jkramarz/TheTick/hardware/Tick.kicad_pcb

## KiCad design hardware/Tick.kicad_pcb (2025-04-05)

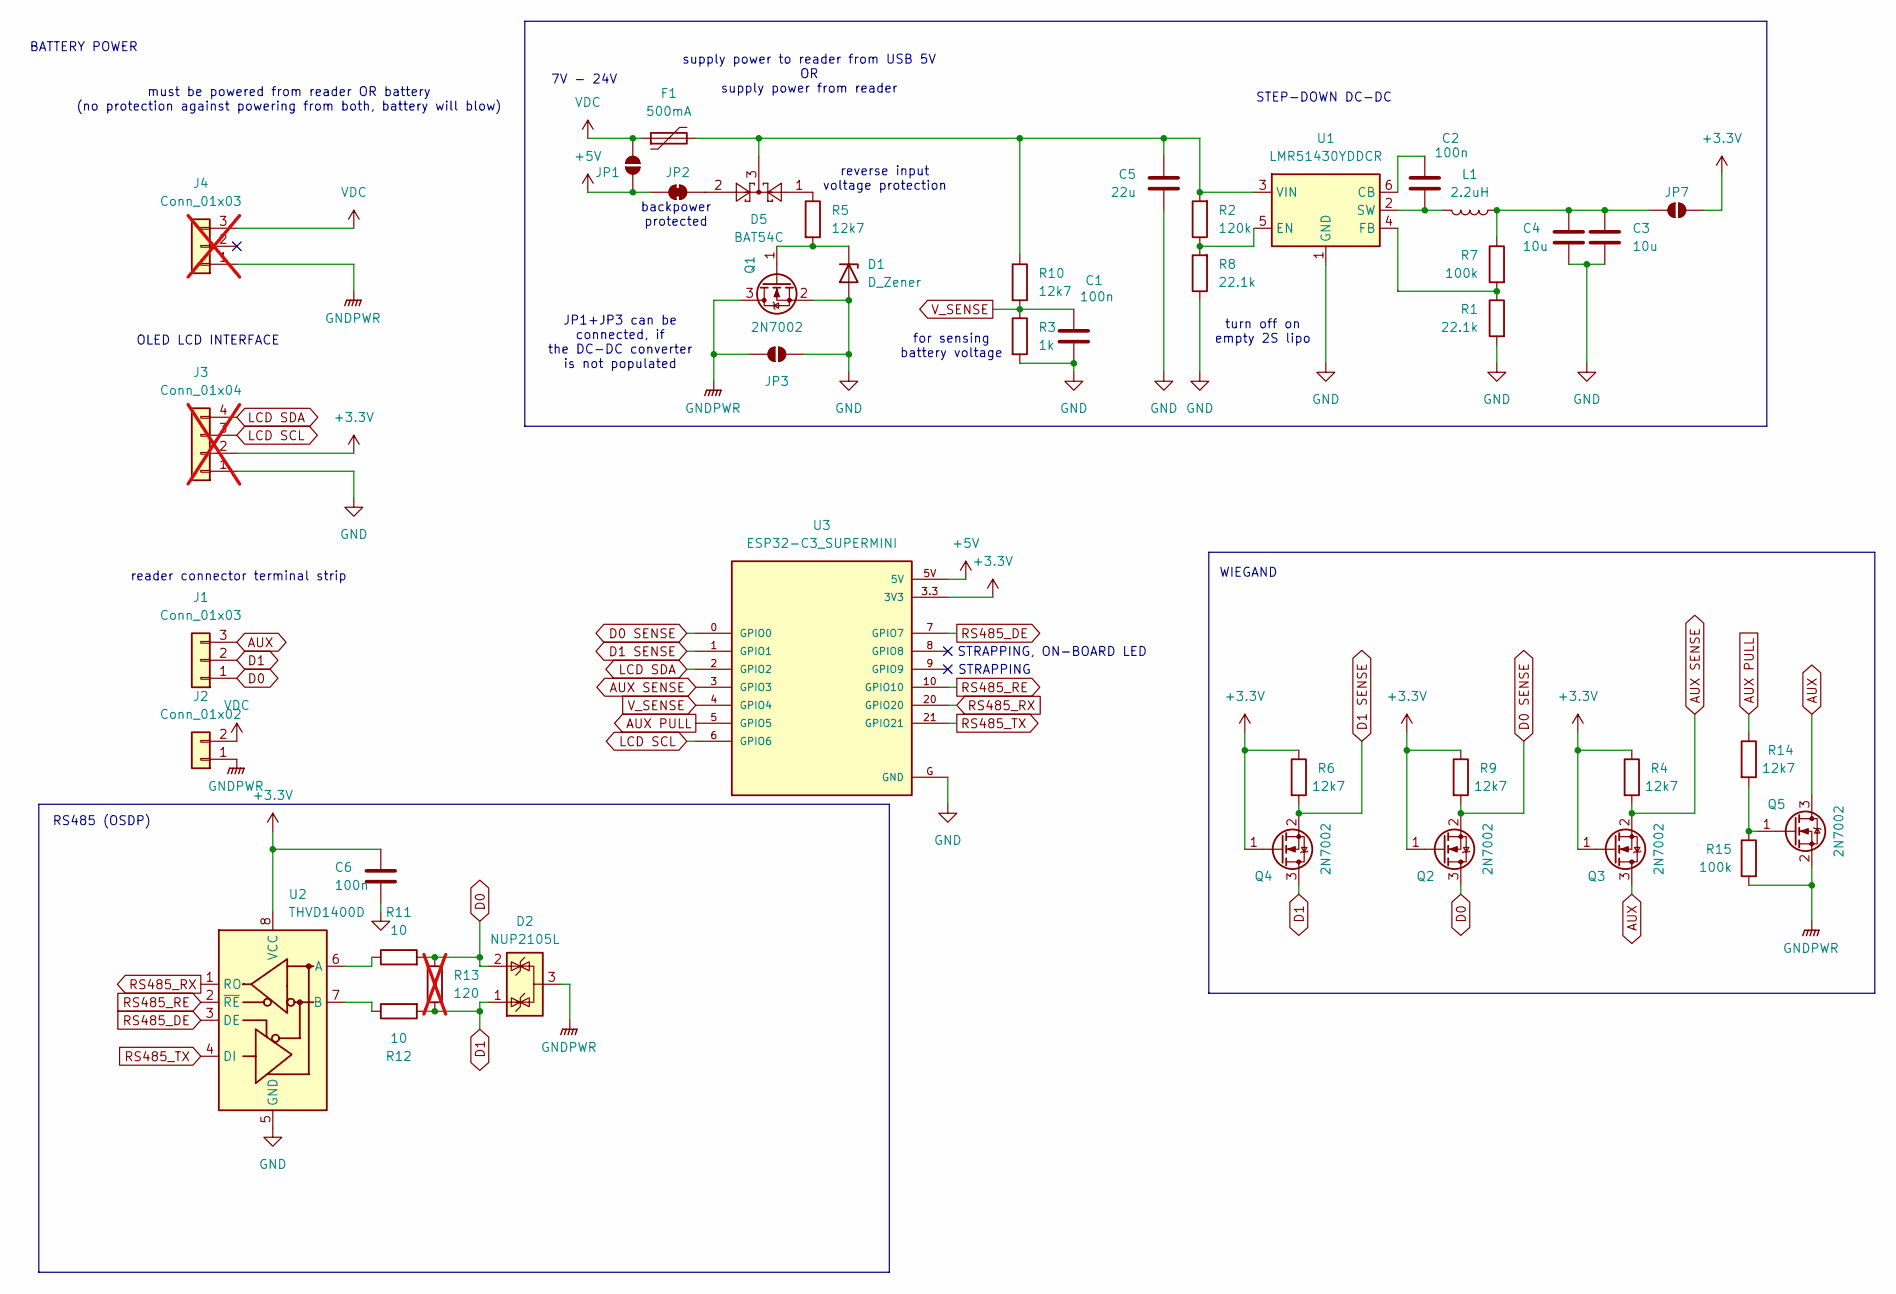
[picture p1: schematic Tick.kicad_sch, The Tick]

Parts:
C1, C2, C6: 100n; C_0805_2012Metric_Pad1.18x1.45mm_HandSolder
C3, C4: 10u; C_0805_2012Metric_Pad1.18x1.45mm_HandSolder
C5: 22u; C_1210_3225Metric_Pad1.33x2.70mm_HandSolder
D1: D_Zener; D_MiniMELF
D2: NUP2105L; SOT-23
D5: BAT54C; SOT-23
F1: 500mA; Fuse_1210_3225Metric_Pad1.42x2.65mm_HandSolder
J1: Conn_01x03; KYOCERA 009176003022006 PTH
J2: Conn_01x02; KYOCERA 009176002022006 PTH
J3: Conn_01x04; PinSocket_1x04_P2.54mm_Vertical; not fitted
J4: Conn_01x03; PinSocket_1x03_P2.54mm_Vertical; not fitted
JP1, JP2, JP3, JP7: SolderJumper_2_Open; SolderJumper-2_P1.3mm_Open_TrianglePad1.0x1.5mm
L1: 2.2uH; L_Changjiang_FXL0420
Q1, Q2, Q3, Q4, Q5: 2N7002; SOT-23
R1, R8: 22.1k; R_0603_1608Metric_Pad0.98x0.95mm_HandSolder
R2: 120k; R_0603_1608Metric_Pad0.98x0.95mm_HandSolder
R3: 1k; R_0603_1608Metric_Pad0.98x0.95mm_HandSolder
R4, R5, R6, R9, R10, R14: 12k7; R_0603_1608Metric_Pad0.98x0.95mm_HandSolder
R7, R15: 100k; R_0603_1608Metric_Pad0.98x0.95mm_HandSolder
R11, R12: 10; R_0603_1608Metric_Pad0.98x0.95mm_HandSolder
R13: 120; R_0603_1608Metric_Pad0.98x0.95mm_HandSolder; not fitted
U1: LMR51430YDDCR; SOT-23-6
U2: THVD1400D; SOIC-8_3.9x4.9mm_P1.27mm
U3: ESP32-C3_SUPERMINI; MODULE_ESP32-C3_SUPERMINI_SMD

Connections:
+3.3V: C6.1, J3.2, JP7.2 (B), Q2.1 (G), Q3.1 (G), Q4.1 (G), R4.1, R6.1, R9.1, U2.8 (VCC), U3.3.3 (3V3)
+5V: JP1.2 (B), JP2.1 (A), U3.5V
AUX: J1.3, Q3.3 (D), Q5.3 (D)
AUX PULL: R14.1, U3.5 (GPIO5)
AUX SENSE: Q3.2 (S), R4.2, U3.3 (GPIO3)
D0: D2.2 (K), J1.1, Q2.3 (D), R11.2, R13.2
D0 SENSE: Q2.2 (S), R9.2, U3.0 (GPIO0)
D1: D2.1 (K), J1.2, Q4.3 (D), R12.2, R13.1
D1 SENSE: Q4.2 (S), R6.2, U3.1 (GPIO1)
GND: C1.2, C3.2, C4.2, C5.2, C6.2, D1.2 (A), J3.1, JP3.1 (A), Q1.2 (S), R1.2, R3.2, R8.1, U1.1 (GND), U2.5 (GND), U3.G (GND)
GNDPWR: D2.3 (A), J2.1, J4.1, JP3.2 (B), Q1.3 (D), Q5.2 (S), R15.2
LCD SCL: J3.3, U3.6 (GPIO6)
LCD SDA: J3.4, U3.2 (GPIO2)
unnamed: D1.1 (K), Q1.1 (G), R5.2
unnamed: D5.1, R5.1
unnamed: D5.2, JP2.2 (B)
unnamed: C3.1, C4.1, JP7.1 (A), L1.1, R7.1
unnamed: Q5.1 (G), R14.2, R15.1
unnamed: C2.1, U1.6 (CB)
unnamed: R2.1, R8.2, U1.5 (EN)
unnamed: R1.1, R7.2, U1.4 (FB)
unnamed: C2.2, L1.2, U1.2 (SW)
unnamed: C5.1, D5.3, F1.2, R2.2, R10.1, U1.3 (VIN)
unnamed: R11.1, U2.6 (A)
unnamed: R12.1, U2.7 (B)
RS485_DE: U2.3 (DE), U3.7 (GPIO7)
RS485_RE: U2.2 (~RE), U3.10 (GPIO10)
RS485_RX: U2.1 (RO), U3.20 (GPIO20)
RS485_TX: U2.4 (DI), U3.21 (GPIO21)
VDC: F1.1, J2.2, J4.3, JP1.1 (A)
V_SENSE: C1.1, R3.1, R10.2, U3.4 (GPIO4)

Notes on the sheet:
supply power to reader from USB 5V OR supply power from reader
STEP-DOWN DC-DC
JP1+JP3 can be connected, if the DC-DC converter is not populated
OLED LCD INTERFACE
reader connector terminal strip
reverse input voltage protection
must be powered from reader OR battery (no protection against powering from both, battery will blow)
7V - 24V
BATTERY POWER
backpower protected
WIEGAND
turn off on empty 2S lipo
STRAPPING, ON-BOARD LED
for sensing battery voltage
STRAPPING
RS485 (OSDP)

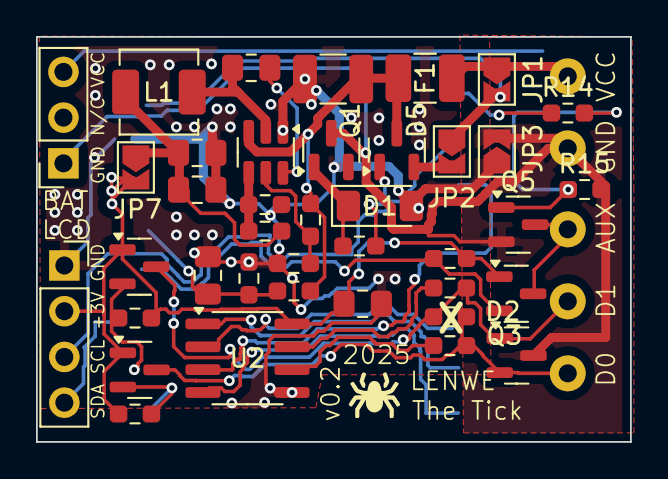
[picture p2: board Tick.kicad_pcb from above]

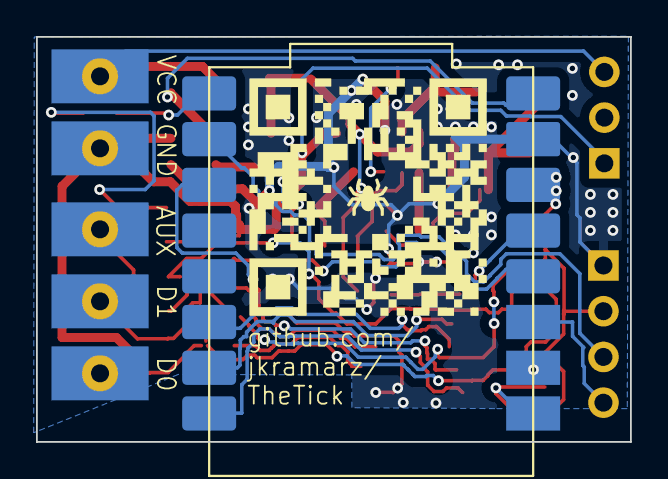
[picture p3: board Tick.kicad_pcb from below]

Board: 2 copper layers, 33.0 x 22.5 mm, 42 parts (3 on the bottom side), 31 nets.
