jkramarz/TheTick/(threads)

Thread 1 (2025-03-24):

„Clear” functionality returns „BAD ARGS”

jzdunczyk, 2025-03-24:
When using the „clear” functionality, a GET /clear request is sent. The response received is 500 Internal server error with a message „BAD ARGS”.

jkramarz, 2025-03-24:
Wrong handler function attached

Closed 2025-03-24.

Thread 12 (2025-03-24):

Prepare hardware BOM

jkramarz, 2025-03-24:
Currently parts comes from partially from Mouser (PTC fuses, AVX headers, RS485 transceivers and voltage regulator), partially from TME (all passives), partially from AliExpress ("vitamins").

Where to order what needs at last documentation, if not simplification to reduce shipping costs (or carbon footprint, you choose what sounds better).

jkramarz, 2025-03-26:
Added to release files: https://github.com/jkramarz/TheTick/releases/tag/hardware-v0.1

Closed 2025-03-26.

Thread 2 (2025-03-24):

USB backpower problem

jkramarz, 2025-03-24:
When JP2 is closed, so VDC is short with 5V, device will fry when connected to >5V and when connected to the computer, it will fry the computer too.
Introduce backpower protection

jkramarz, 2025-03-24:
In progress, for hardware rev 0.2.

Populating schottky diode on JP2 partialy backports fix, but breaks reverse polarity protection (another diode is needed, but there's no space for one)

jkramarz, 2025-03-25:
Fixed on branch hardware-v0.2.

Closed 2025-03-25.

Thread 4 (2025-03-24):

D1, D2 - wrong footprint

jkramarz, 2025-03-24:
I've no idea what fits there, but for sure not the parts from BOM. Works without, but must be fixed in rev v0.2.

jkramarz, 2025-03-25:
Should be SOD80

jkramarz, 2025-03-25:
Changed to MiniMELF on branch hardware-v0.2.

Closed 2025-03-25.

Thread 8 (2025-03-24):

Replace AVX 9175-000 connectors with 9176-000

jkramarz, 2025-03-24:
Measure, create KiCad footprints. Replace on PCB and re-route.

jkramarz, 2025-03-25:
Fixed on branch hardware-v0.2.

Closed 2025-03-25.

Thread 9 (2025-03-24):

Add plated holes for wires, if using instead of IDC connectors

jkramarz, 2025-03-24:
Just plain holes for wires to use with t-tap connectors, sharing the PCB space with AVX connectors. Would be more structurally sound, compared to surface-mounting.

jkramarz, 2025-03-25:
Fixed on branch hardware-v0.2.

Closed 2025-03-25.

Thread 16 (2025-03-26):

Change PMIC

jkramarz, 2025-03-26:
28V max VDC should be sufficient, so changing buck PMIC from [LMR51430YDDCR](https://www.ti.com/lit/ds/symlink/lmr51430.pdf) to [TPS54202DDCR](https://www.ti.com/lit/ds/symlink/tps54202.pdf) would reduce DC/DC converter cost by 25%.
Hard to get [HPI0420-2R2](https://www.tme.eu/Document/b467ae6daee59df5e2ed68809c99b965/HPI0420.pdf) inductor can be then replaced with common [DLG-0403-100](https://www.tme.eu/Document/bda580f72a60a2225c2f6576c2740ae1/dlg-0504.pdf), capacitors and resistors needs to be adjusted accordingly.
It should be possible to assemble prototype on the same board (footprint matches good enough) to validate and characterise the new converter.

jkramarz, 2025-04-17:
Design confirmed to be working. Slightly increased noise level?

Closed 2025-04-10.

Thread 22 (2025-09-06):

Reverse voltage protection problem

jkramarz, 2025-09-06:
In design v0.2B for some reason Q1 (2N7002) goes bad (for VCC=9V, source-drain voltage becomes 2V).
It seems to be related to use of specific power supplies, but it is a design flaw or use of incorrect part.

To compare to v0.2A - maybe Zener diode (dropped in v0.2B) protects against this issue.

jkramarz, 2025-09-06:
v0.2A prototypes - transistors from [Diotec Semiconductor](https://www.tme.eu/Document/2c77ccad04f07fe8219ceb50e33fbf0b/2n7002.pdf) with slightly higher rating.
v0.2B prototypes - transistors from [[Jiangsu Changjing Electronics Technology](https://jlcpcb.com/api/file/downloadByFileSystemAccessId/8550724090244980736).
