jkramarz/TheTick/(notices)

Notices in the files:
hardware/Tick.kicad_sch:
Copyright (C) 2024, 2025 Jakub \"lenwe\" Kramarz
CERN Open Hardware Licence Version 2 - Strongly Reciprocal
